Swapnil55559/Mirosot_Bot/PCB Files/mirosot_brd.png

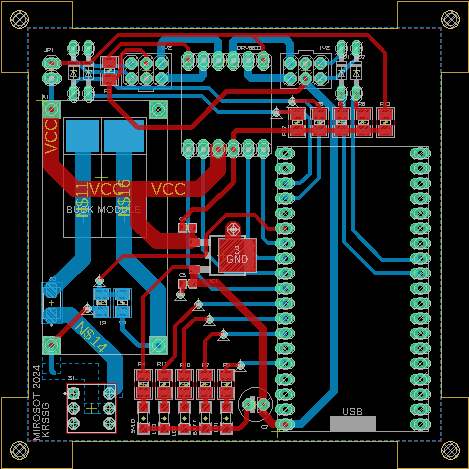
PCB Files/mirosot_brd.png
