Swapnil55559/Mirosot_Bot/PCB Files/mirosot_sch.png

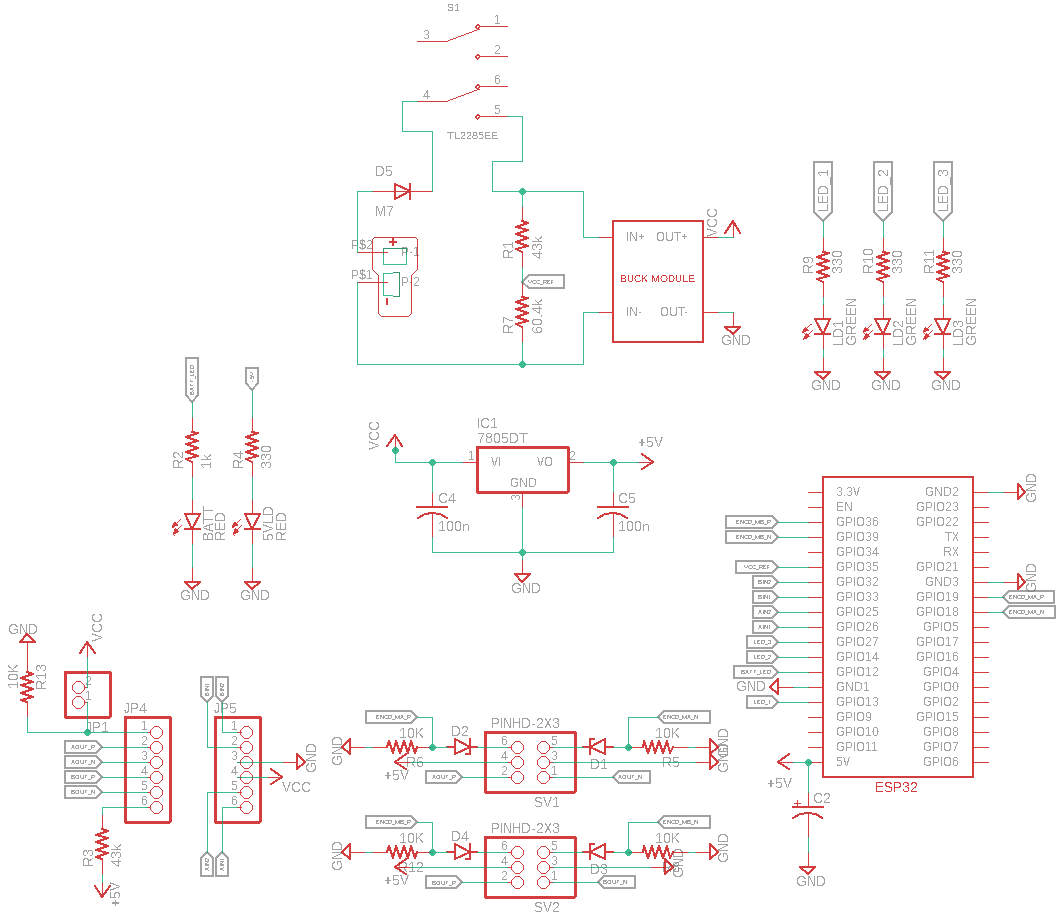
PCB Files/mirosot_sch.png
