Swapnil55559/Mirosot_Bot/PCB Files/mirsot_sch-final.brd

## EAGLE design PCB Files/mirsot_sch-final.brd (2024-01-06)

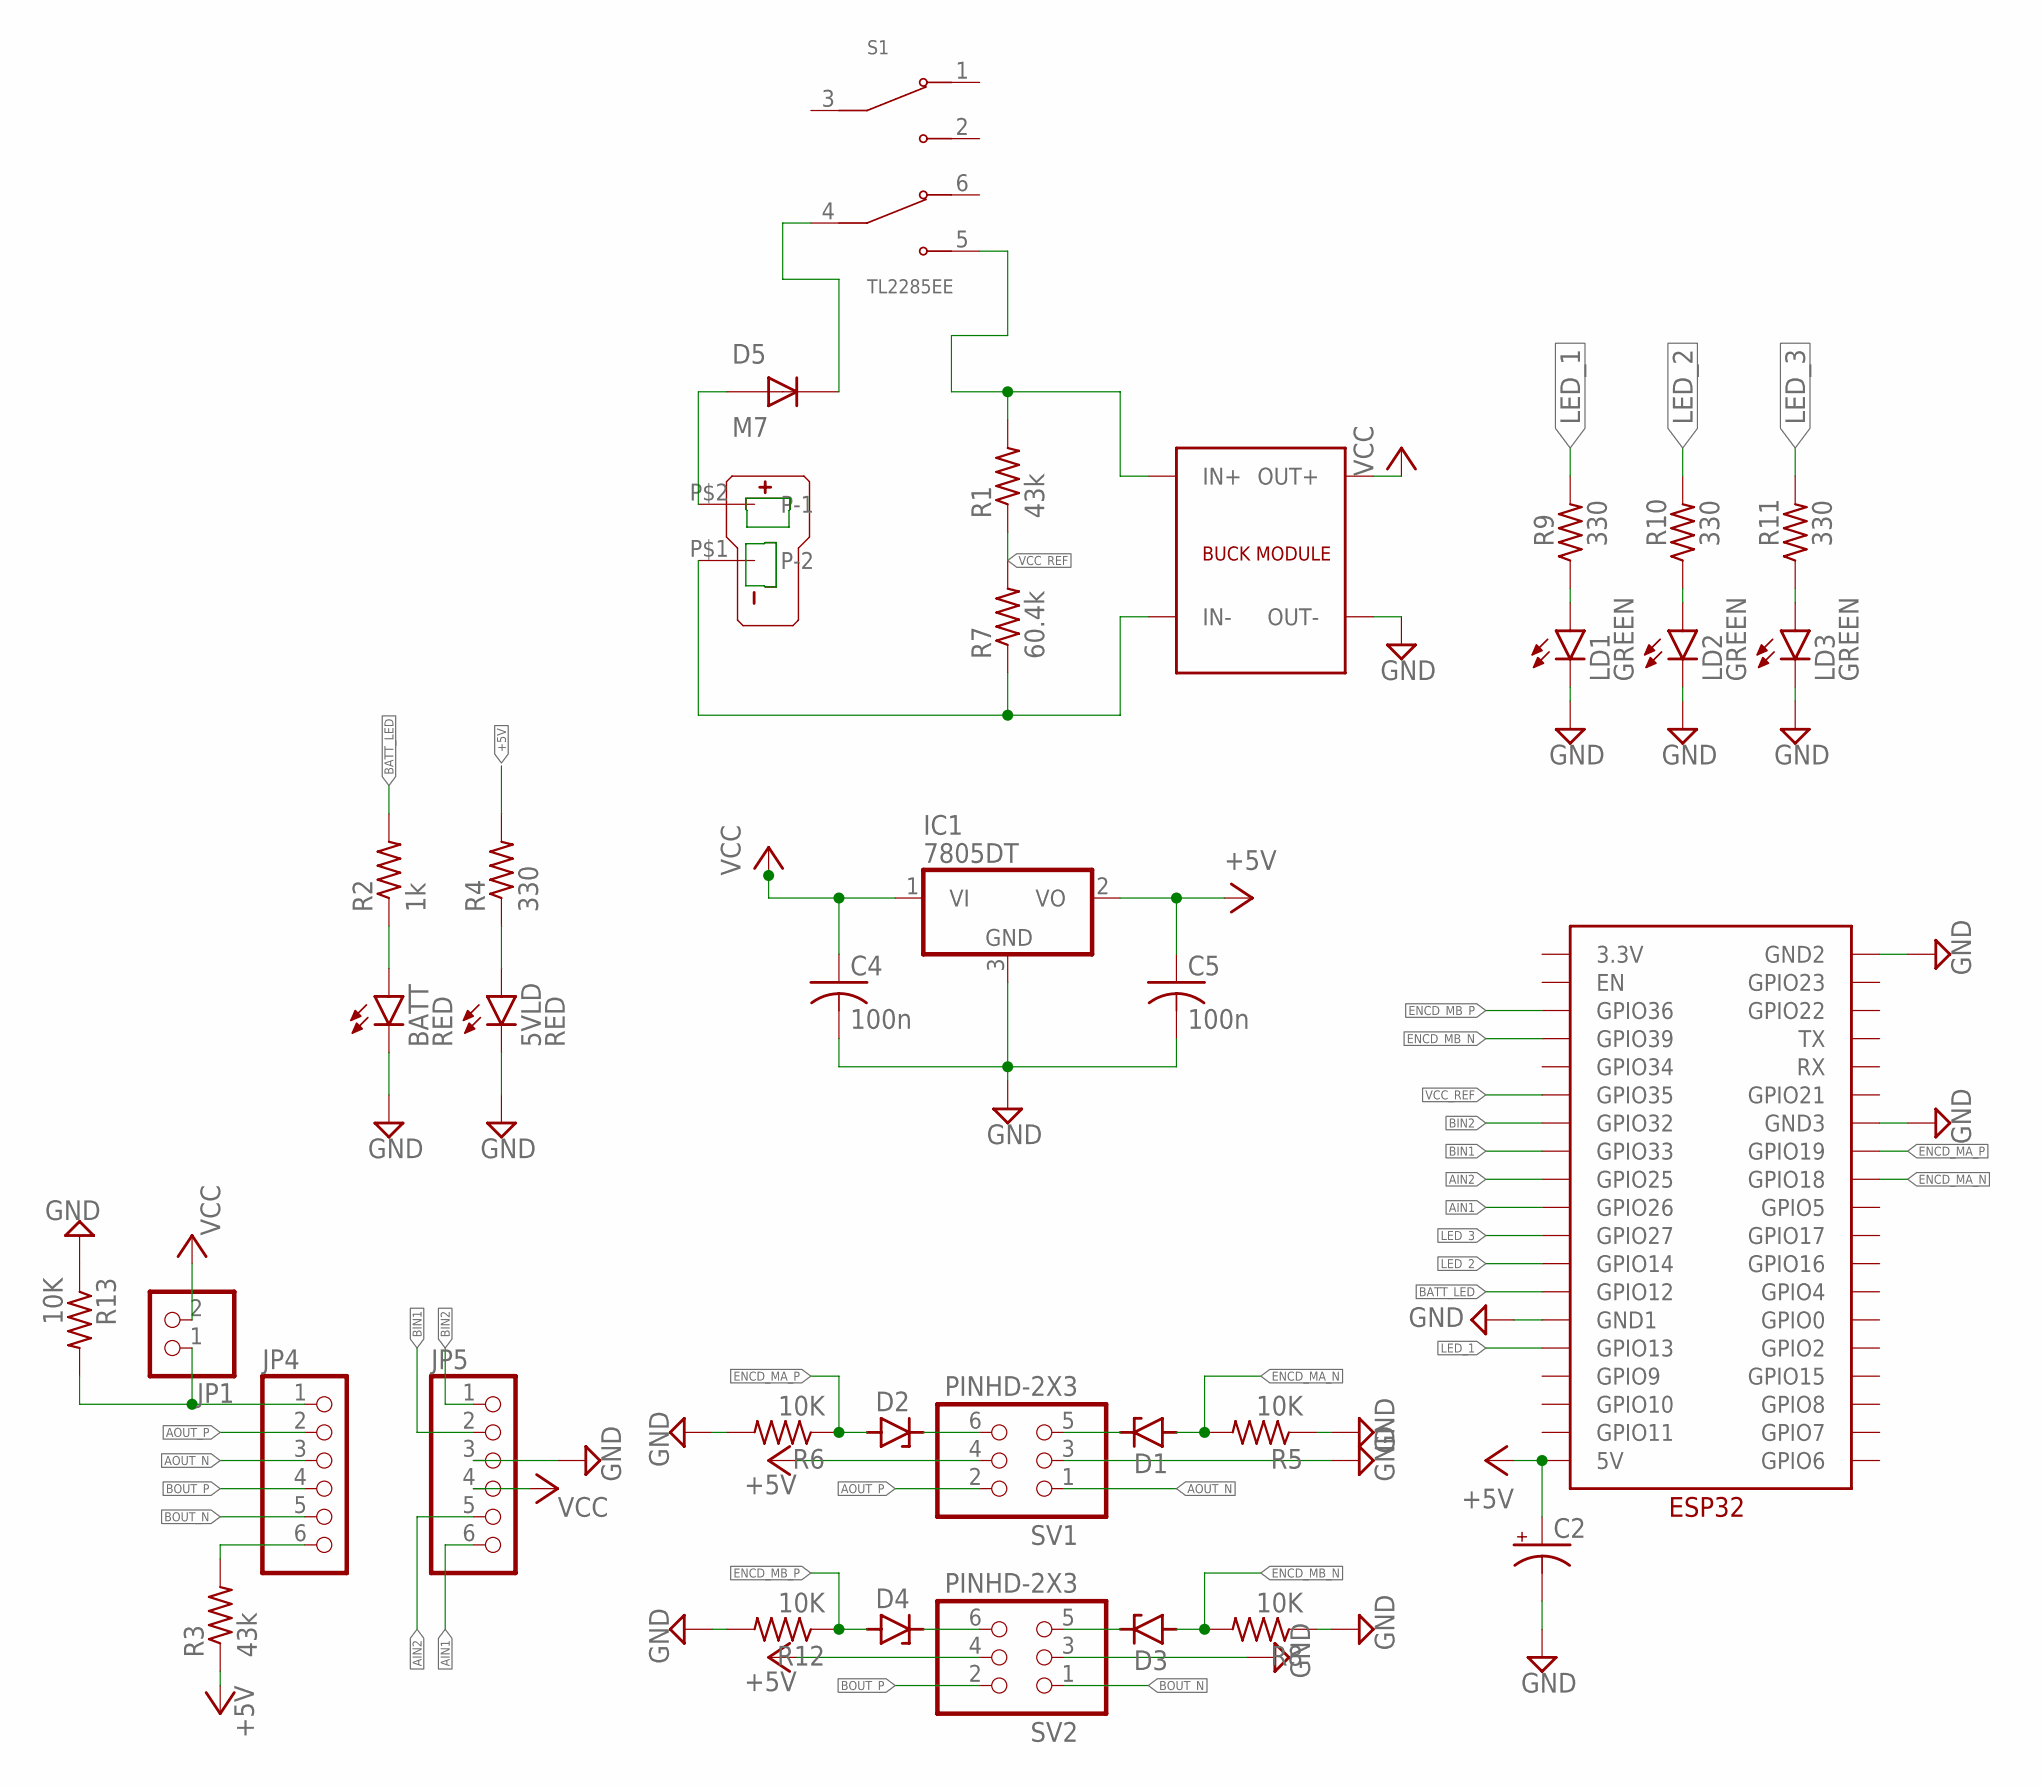
[picture p3: schematic mirsot_sch-final.sch]

Parts:
5VLD: RED; SML1206
BATT: RED; SML1206
C2: CPOL-USE2.5-6; E2,5-6
C4, C5: 100n; C0603K
D1, D2, D3, D4: ZENER-DIODEDO34-7; DO34Z7
D5: M7; DIOM505270X240
IC1: 7805DT; TO252
JP1: PINHD-1X2; 1X02
JP4, JP5: PINHD-1X6; 1X06
LD1, LD2, LD3: GREEN; SML1206
R1, R3: 43k; M1206
R2: 1k; M1206
R4, R9, R10, R11: 330; M1206
R5, R6, R8, R12, R13: 10K; M1206
R7: 60.4k; M1206
S1: TL2285EE; SW_TL2285EE
SV1, SV2: PINHD-2X3; 2X03
U$1: T_PLUG_CONNECTOR_H
U$2: ESP32
U$3: BUCK_CONVERTER

Connections:
+5V: C2.+, C5.1, IC1.2 (VO), R3.1, R4.2, SV1.4, SV2.4, U$2.5V
AIN1: JP5.6, U$2.GPIO26
AIN2: JP5.5, U$2.GPIO25
AOUT_N: JP4.3, SV1.1
AOUT_P: JP4.2, SV1.2
BATT_LED: R2.2, U$2.GPIO12
BIN1: JP5.2, U$2.GPIO33
BIN2: JP5.1, U$2.GPIO32
BOUT_N: JP4.5, SV2.1
BOUT_P: JP4.4, SV2.2
ENCD_MA_N: D1.A, R5.2, U$2.GPIO18
ENCD_MA_P: D2.A, R6.1, U$2.GPIO19
ENCD_MB_N: D3.A, R8.2, U$2.GPIO39
ENCD_MB_P: D4.A, R12.1, U$2.GPIO36
GND: 5VLD.C, BATT.C, C2.-, C4.2, C5.2, IC1.3 (GND), JP5.3, LD1.C, LD2.C, LD3.C, R5.1, R6.2, R8.1, R12.2, R13.1, SV1.3, SV2.3, U$2.GND1, U$2.GND2, U$2.GND3, U$3.OUT-
LED_1: R9.2, U$2.GPIO13
LED_2: R10.2, U$2.GPIO14
LED_3: R11.2, U$2.GPIO27
unnamed: JP4.6, R3.2
unnamed: BATT.A, R2.1
unnamed: LD1.A, R9.1
unnamed: LD2.A, R10.1
unnamed: 5VLD.A, R4.1
unnamed: D1.C, SV1.5
unnamed: D2.C, SV1.6
unnamed: D3.C, SV2.5
unnamed: LD3.A, R11.1
unnamed: D4.C, SV2.6
unnamed: D5.A, U$1.P$2 (P-1)
unnamed: JP1.1, JP4.1, R13.2
unnamed: D5.C, S1.4 (COM2)
unnamed: R1.2, S1.5 (NO2), U$3.IN+
unnamed: R7.1, U$1.P$1 (P-2), U$3.IN-
VCC: C4.1, IC1.1 (VI), JP1.2, JP5.4, U$3.OUT+
VCC_REF: R1.1, R7.2, U$2.GPIO35

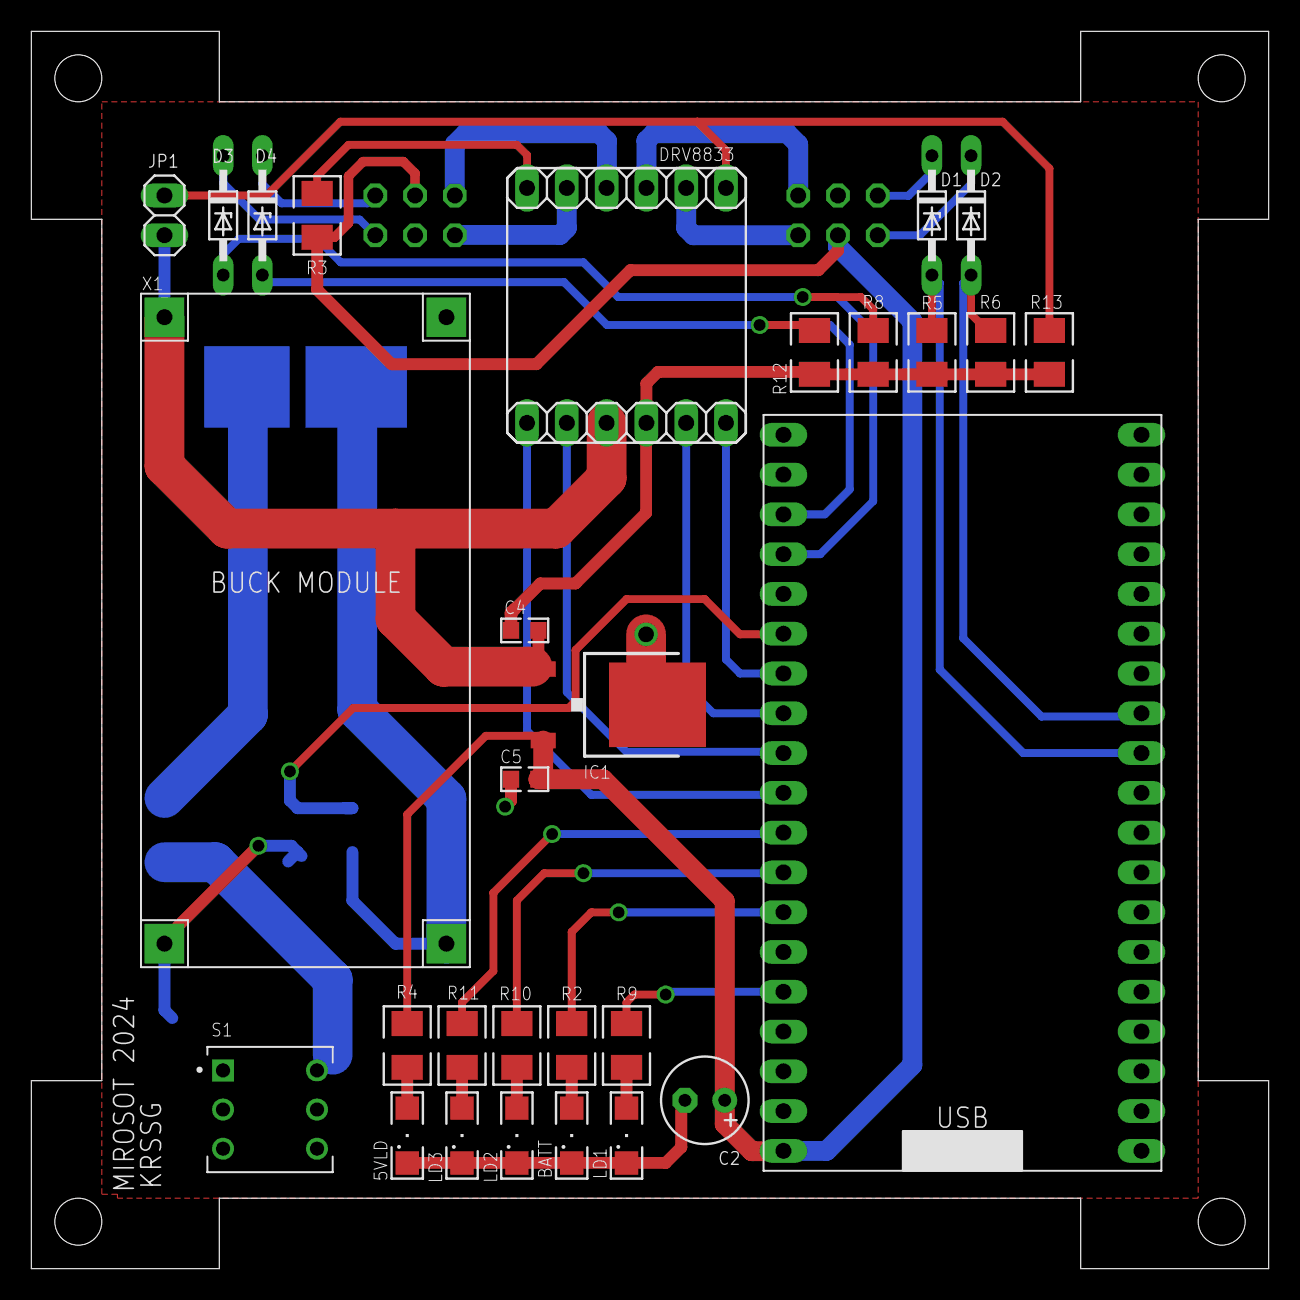
[picture p4: board mirsot_sch-final.brd from above]

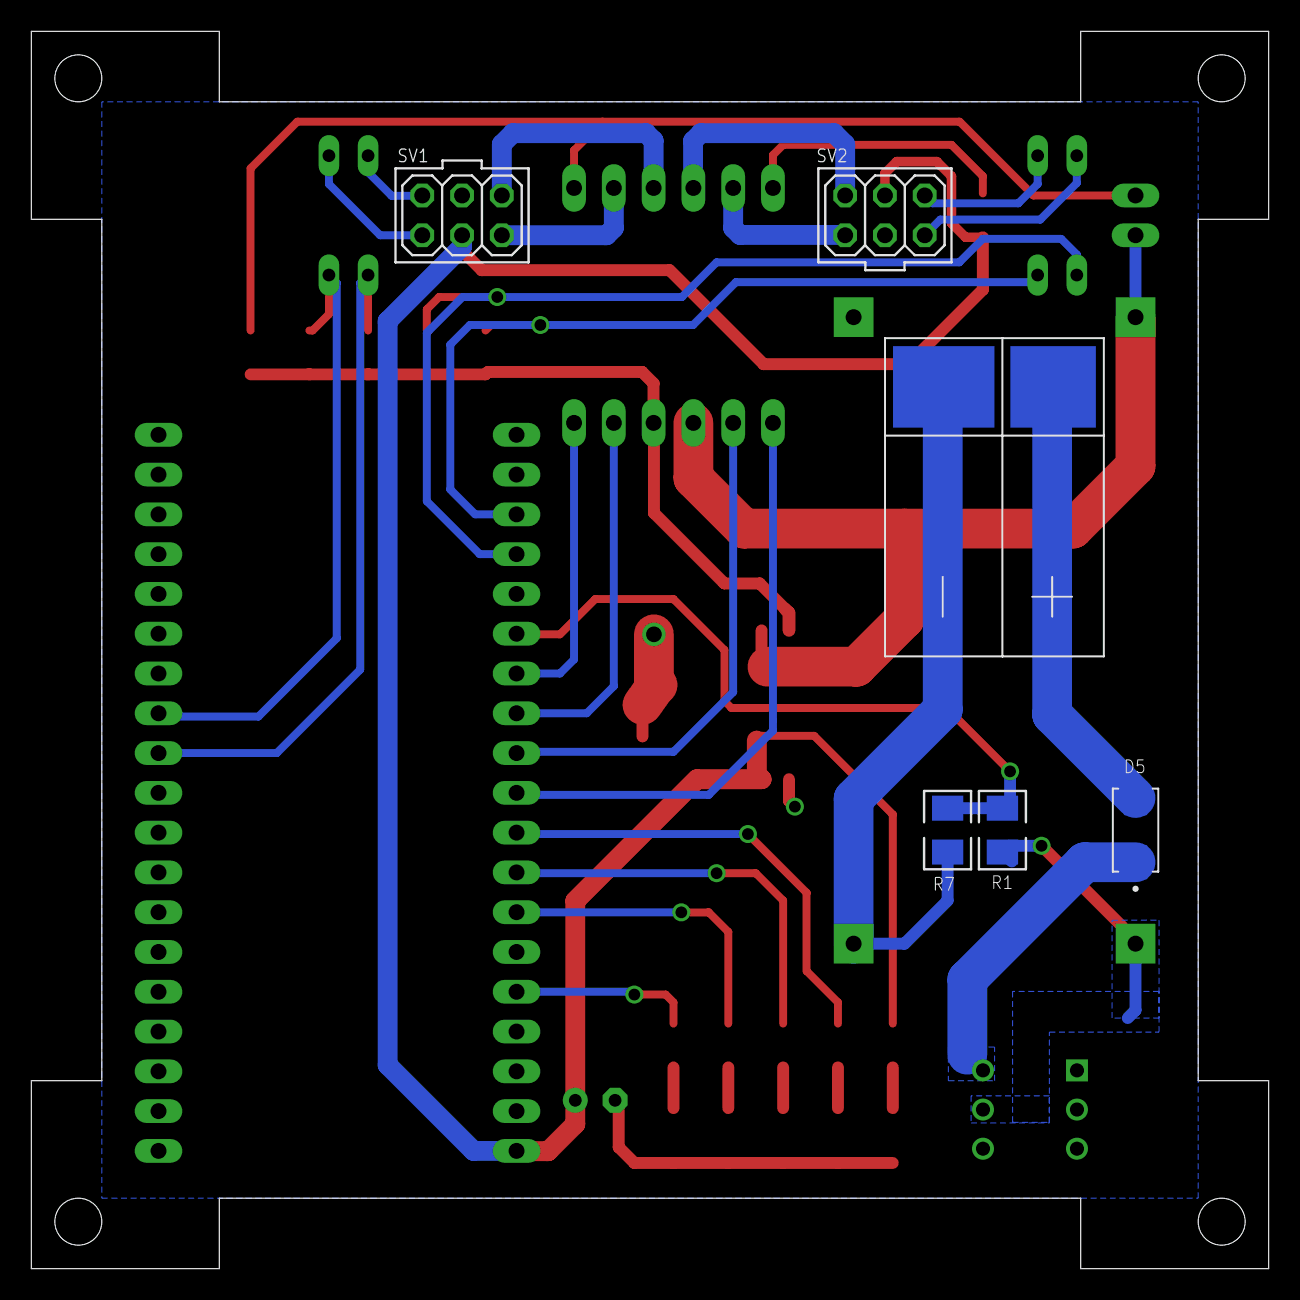
[picture p5: board mirsot_sch-final.brd from below]

Board: 2 copper layers, 79.0 x 79.0 mm, 36 parts (6 on the bottom side), 35 nets.
